theloukou/xmasSmartTree/PCB/xmasTree.kicad_pcb

## KiCad design PCB/xmasTree.kicad_pcb (2024-12-06)

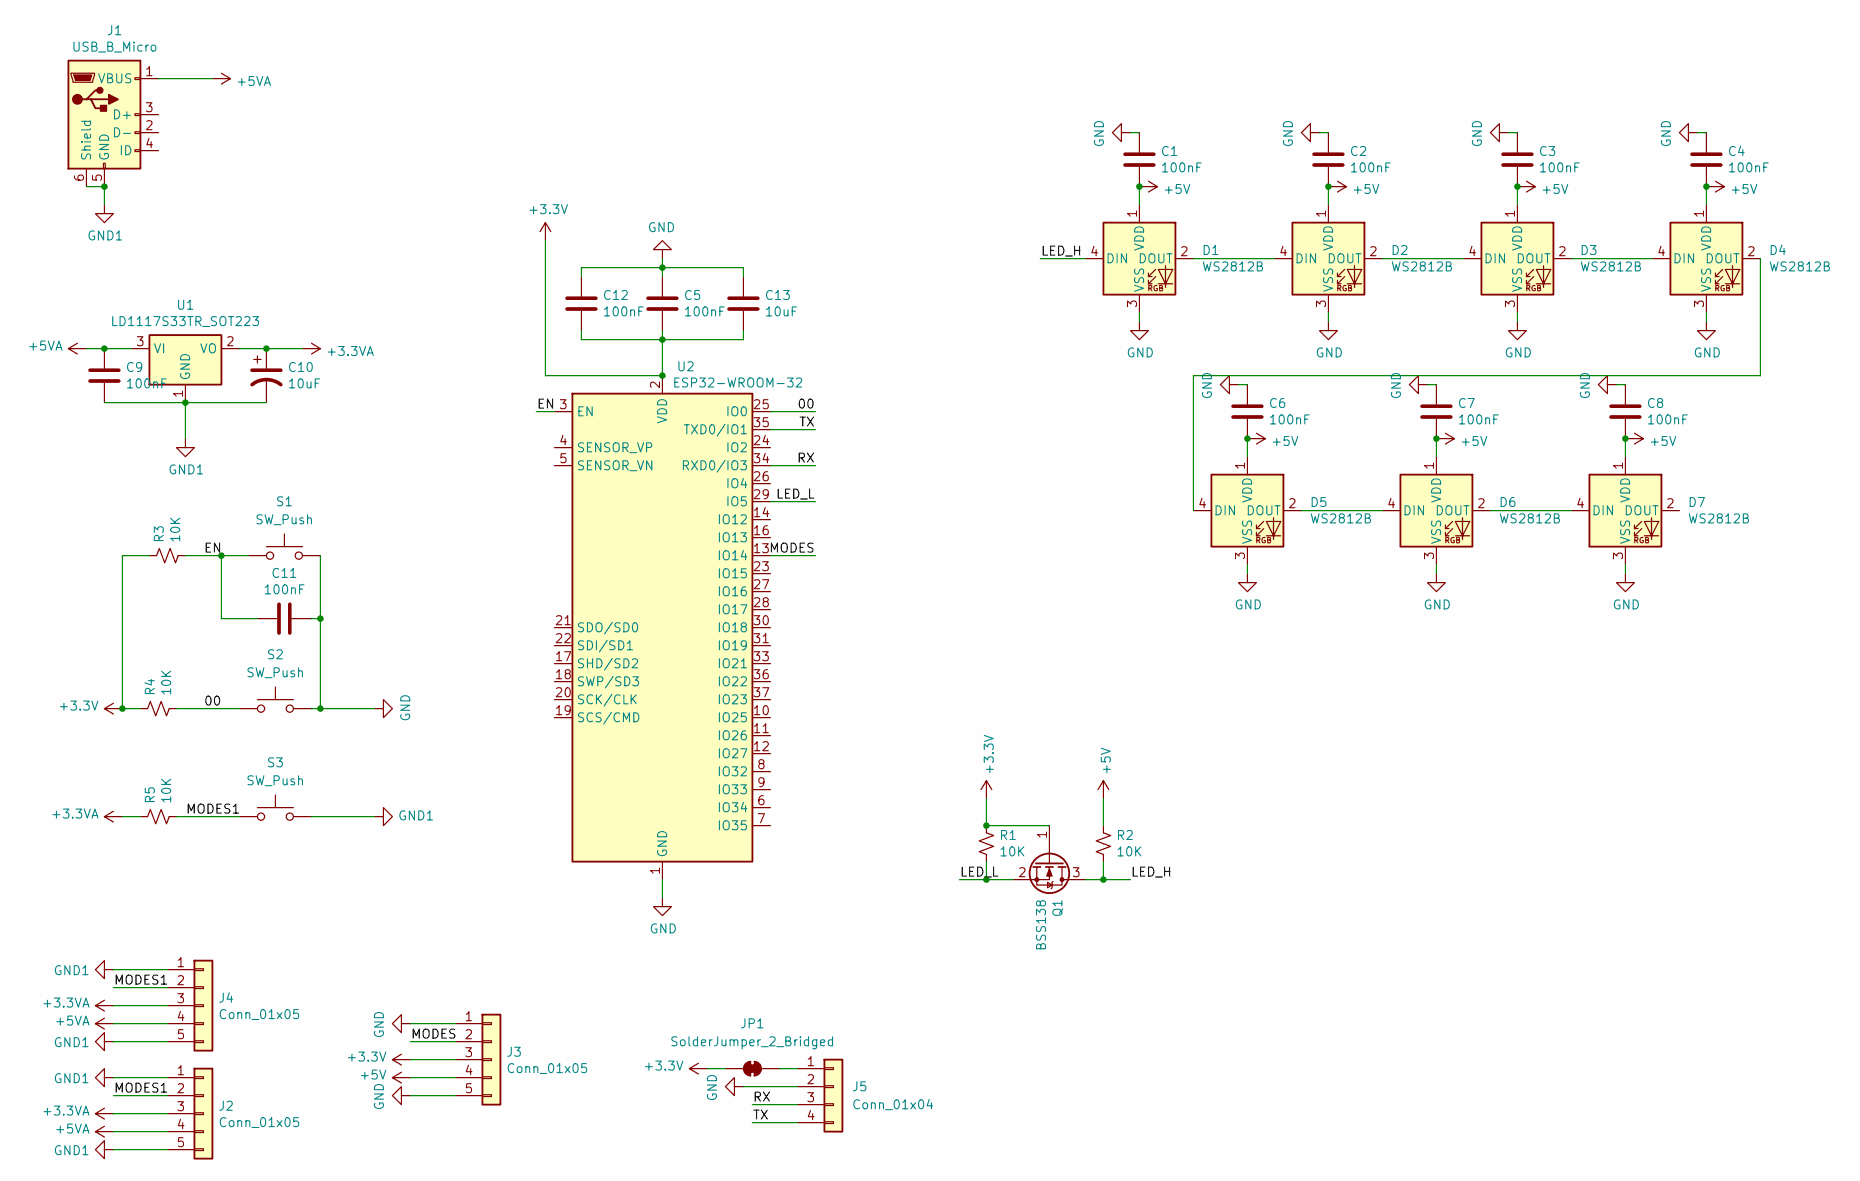
[picture p1: schematic xmasTree.kicad_sch, xmasSmartTree]

Parts:
C1, C2, C3, C4, C5, C6, C7, C8, C9, C11, C12: 100nF; C_0805_2012Metric_Pad1.18x1.45mm_HandSolder
C10: 10uF; CP_Radial_D10.0mm_P5.00mm_P7.50mm
C13: 10uF; C_0805_2012Metric_Pad1.18x1.45mm_HandSolder
D1, D2, D3, D4, D5, D6, D7: WS2812B; LED_WS2812B_PLCC4_5.0x5.0mm_P3.2mm
J1: USB_B_Micro; USB_Micro-B_Molex-105017-0001
J2, J3, J4: Conn_01x05; PinHeader_1x05_P2.54mm_Vertical
J5: Conn_01x04; PinSocket_1x04_P2.54mm_Horizontal
JP1: SolderJumper_2_Bridged; SolderJumper-2_P1.3mm_Bridged_Pad1.0x1.5mm
Q1: BSS138; SOT-23
R1, R2, R3, R4, R5: 10K; R_0805_2012Metric_Pad1.20x1.40mm_HandSolder
S1, S2, S3: SW_Push; SW_PUSH_1P1T_6x3.5mm_H4.3_APEM_MJTP1243
U1: LD1117S33TR_SOT223; SOT-223-3_TabPin2
U2: ESP32-WROOM-32

Connections:
+3.3V: C5.2, C12.2, C13.2, J3.3, JP1.1 (A), Q1.1 (G), R1.1, R3.1, R4.1, U2.2 (VDD)
+3.3VA: C10.1, J2.3, J4.3, R5.1, U1.2 (VO)
+5V: C1.2, C2.2, C3.2, C4.2, C6.2, C7.2, C8.2, D1.1 (VDD), D2.1 (VDD), D3.1 (VDD), D4.1 (VDD), D5.1 (VDD), D6.1 (VDD), D7.1 (VDD), J3.4, R2.1
+5VA: C9.1, J1.1 (VBUS), J2.4, J4.4, U1.3 (VI)
/00: R4.2, S2.1, U2.25 (IO0)
/EN: C11.2, R3.2, S1.1, U2.3 (EN)
/LED_H: D1.4 (DIN), Q1.3 (D), R2.2
/LED_L: Q1.2 (S), R1.2, U2.29 (IO5)
/MODES: J3.2, U2.13 (IO14)
/MODES1: J2.2, J4.2, R5.2, S3.1
/RX: J5.3, U2.34 (RXD0/IO3)
/TX: J5.4, U2.35 (TXD0/IO1)
GND: C1.1, C2.1, C3.1, C4.1, C5.1, C6.1, C7.1, C8.1, C11.1, C12.1, C13.1, D1.3 (VSS), D2.3 (VSS), D3.3 (VSS), D4.3 (VSS), D5.3 (VSS), D6.3 (VSS), D7.3 (VSS), J3.1, J3.5, J5.2, S1.2, S2.2, U2.1 (GND), U2.15 (GND), U2.38 (GND), U2.39 (GND)
GND1: C9.2, C10.2, J1.5 (GND), J1.6 (Shield), J2.1, J2.5, J4.1, J4.5, S3.2, U1.1 (GND)
unnamed: D1.2 (DOUT), D2.4 (DIN)
unnamed: D2.2 (DOUT), D3.4 (DIN)
unnamed: D3.2 (DOUT), D4.4 (DIN)
unnamed: D4.2 (DOUT), D5.4 (DIN)
unnamed: D5.2 (DOUT), D6.4 (DIN)
unnamed: D6.2 (DOUT), D7.4 (DIN)
unnamed: J5.1, JP1.2 (B)

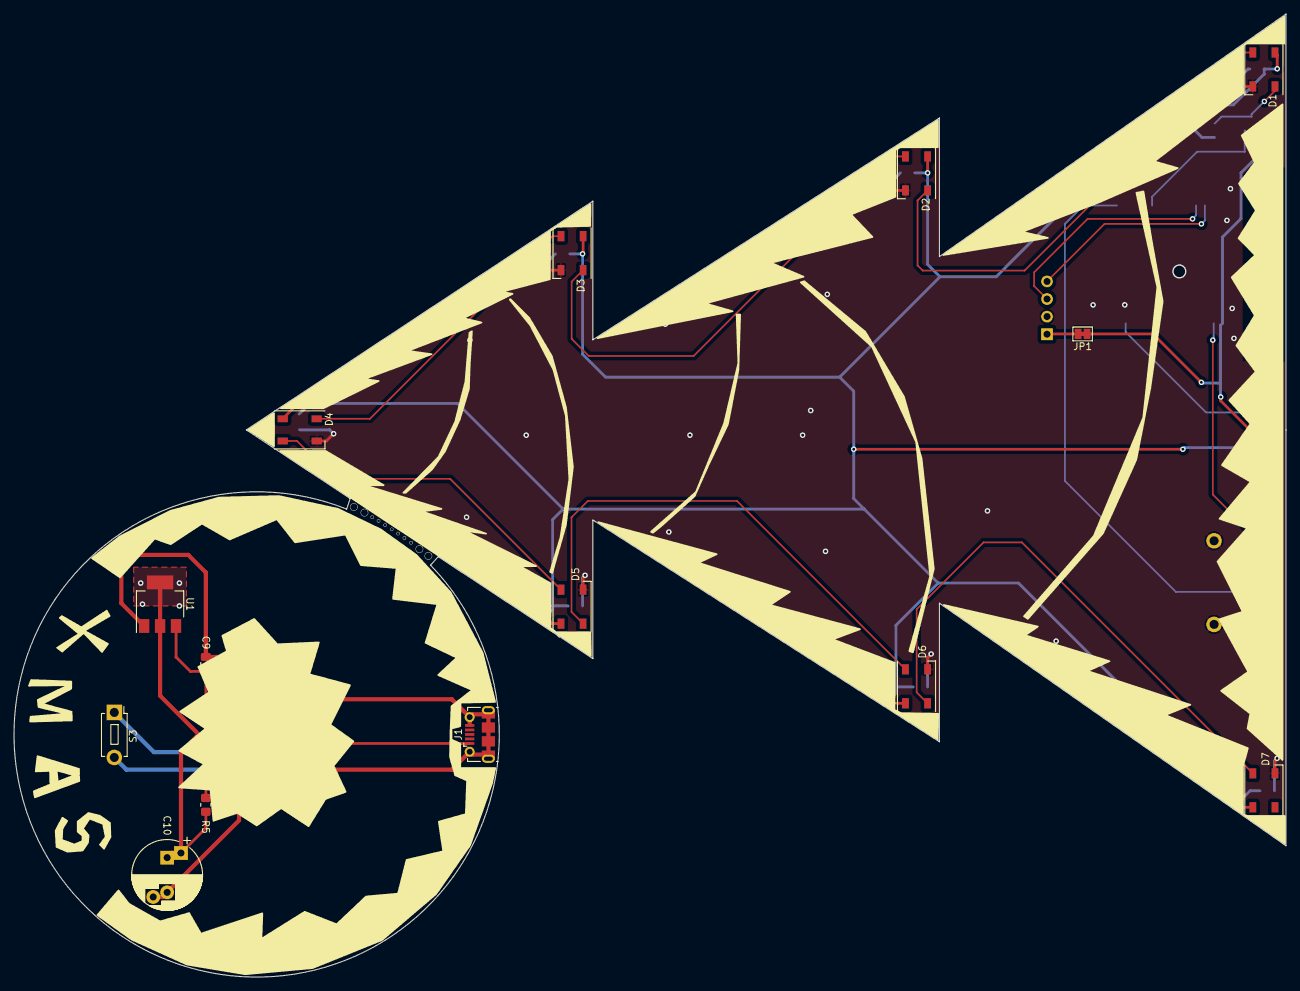
[picture p2: board xmasTree.kicad_pcb from above]

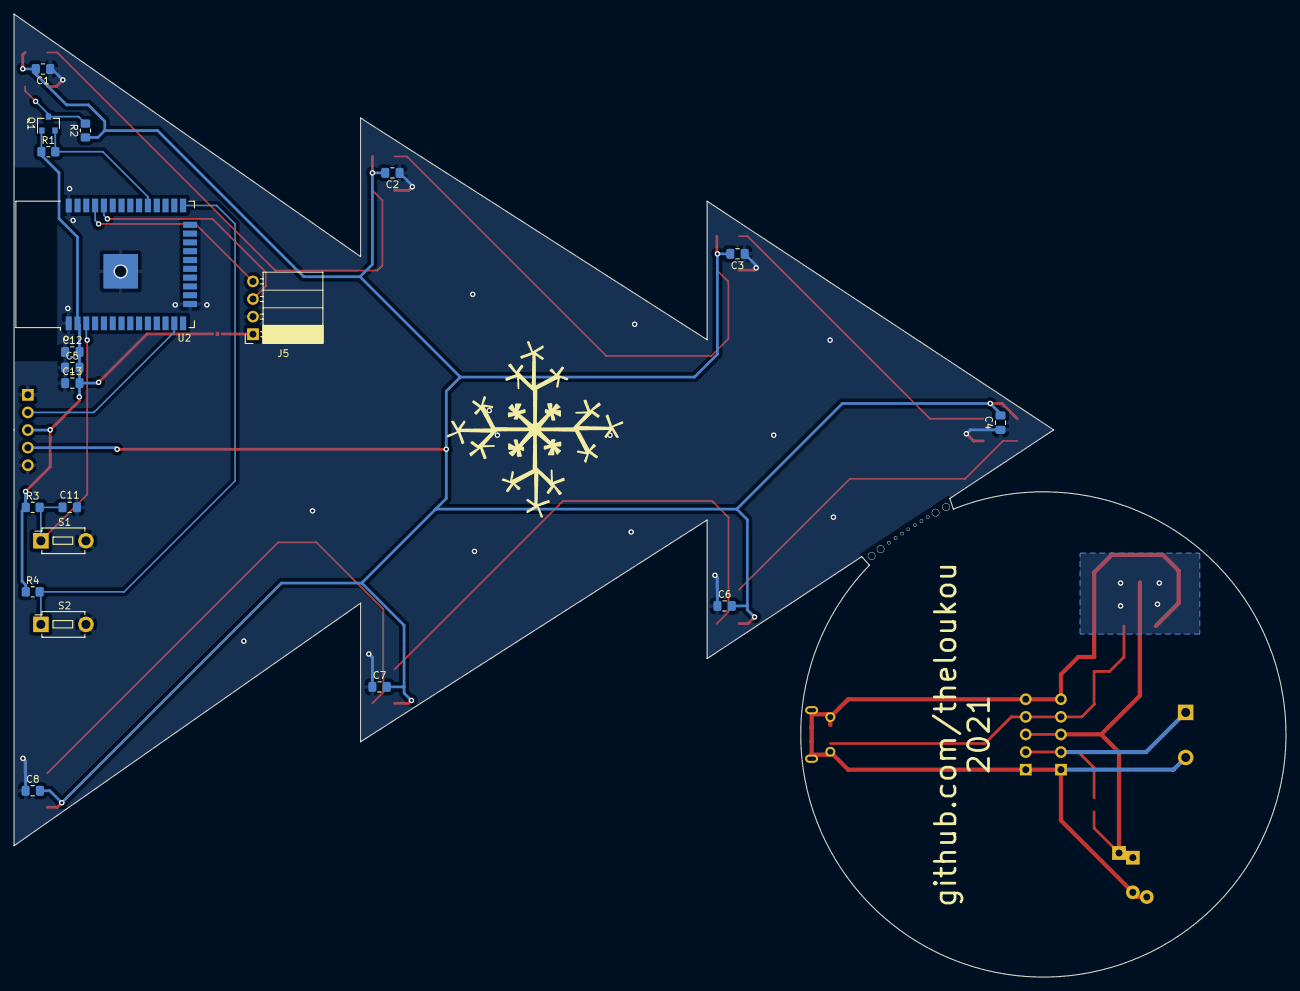
[picture p3: board xmasTree.kicad_pcb from below]

Board: 2 copper layers, 183.5 x 138.9 mm, 37 parts (20 on the bottom side), 21 nets.
