theloukou/xmasSmartTree/(commit log)

2024-11-11 Initial commit Includes R1 of PCB and Fab outputs
    [base.kicad_pcb, base.kicad_sch, base.sch, tree.kicad_pcb, tree.kicad_sch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]
2024-12-06 Updated to R2 4pin buttons were connected wrong. Swapped them to 2pin narrow version at the same time.
    [xmasTree-B_Cu.gbr, xmasTree-B_Mask.gbr, xmasTree-B_Paste.gbr, xmasTree-B_Silkscreen.gbr, xmasTree-Edge_Cuts.gbr, xmasTree-F_Cu.gbr, xmasTree-F_Mask.gbr, xmasTree-F_Paste.gbr]
2024-12-06 Added sample ESPhome yaml Long press MODES button to turn on/off. Defaults to random twinkle effect. Double click to cycle through all effects.
